alexh95/3d-models/u3421we-riser/docs/concepts-exploded.png

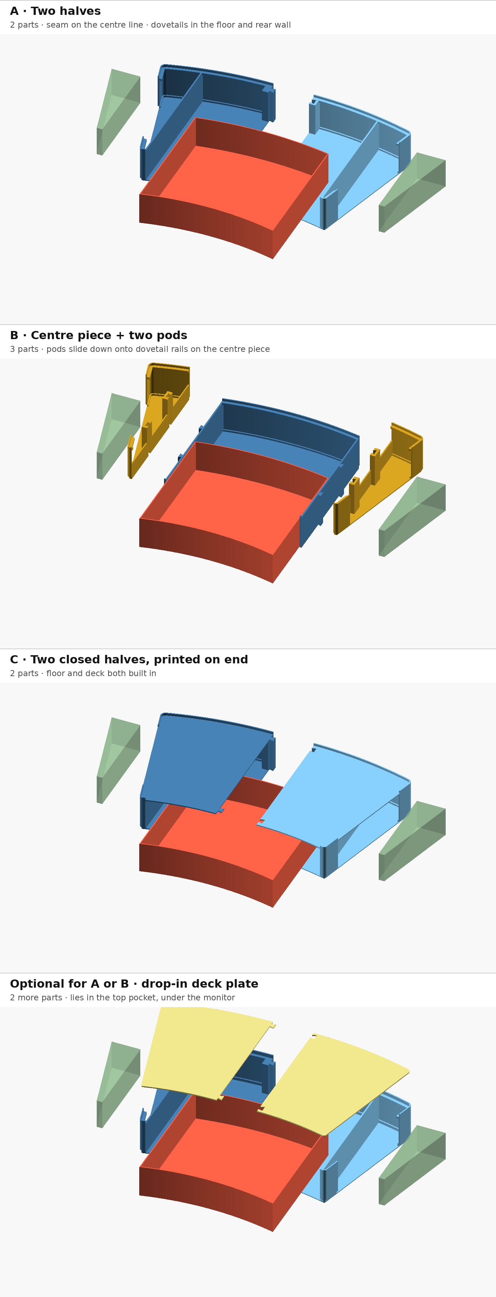
u3421we-riser/docs/concepts-exploded.png
