alexh95/3d-models/u3421we-riser/docs/interface-exploded.png

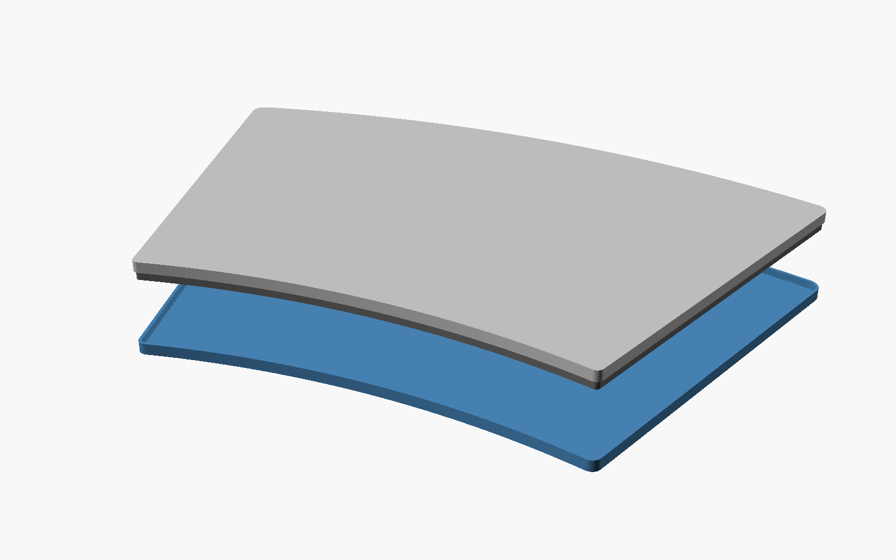
u3421we-riser/docs/interface-exploded.png
