alexh95/3d-models/u3421we-riser/docs/joint-concepts.png

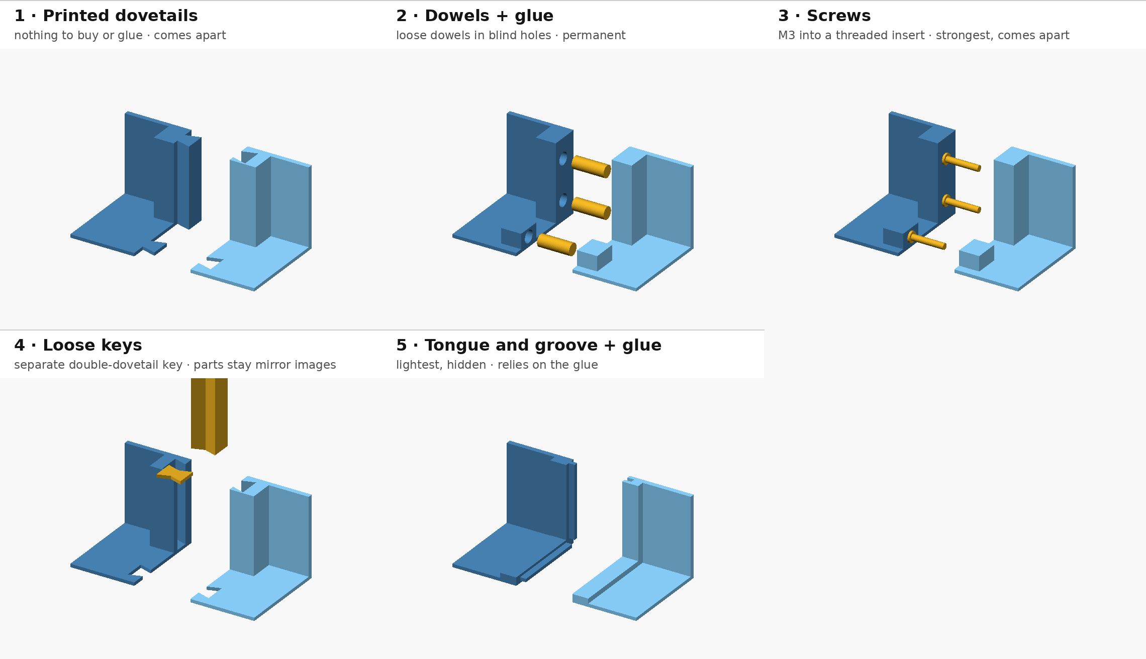
u3421we-riser/docs/joint-concepts.png
