alexh95/3d-models/u3421we-riser/docs/outline-u3421we.png

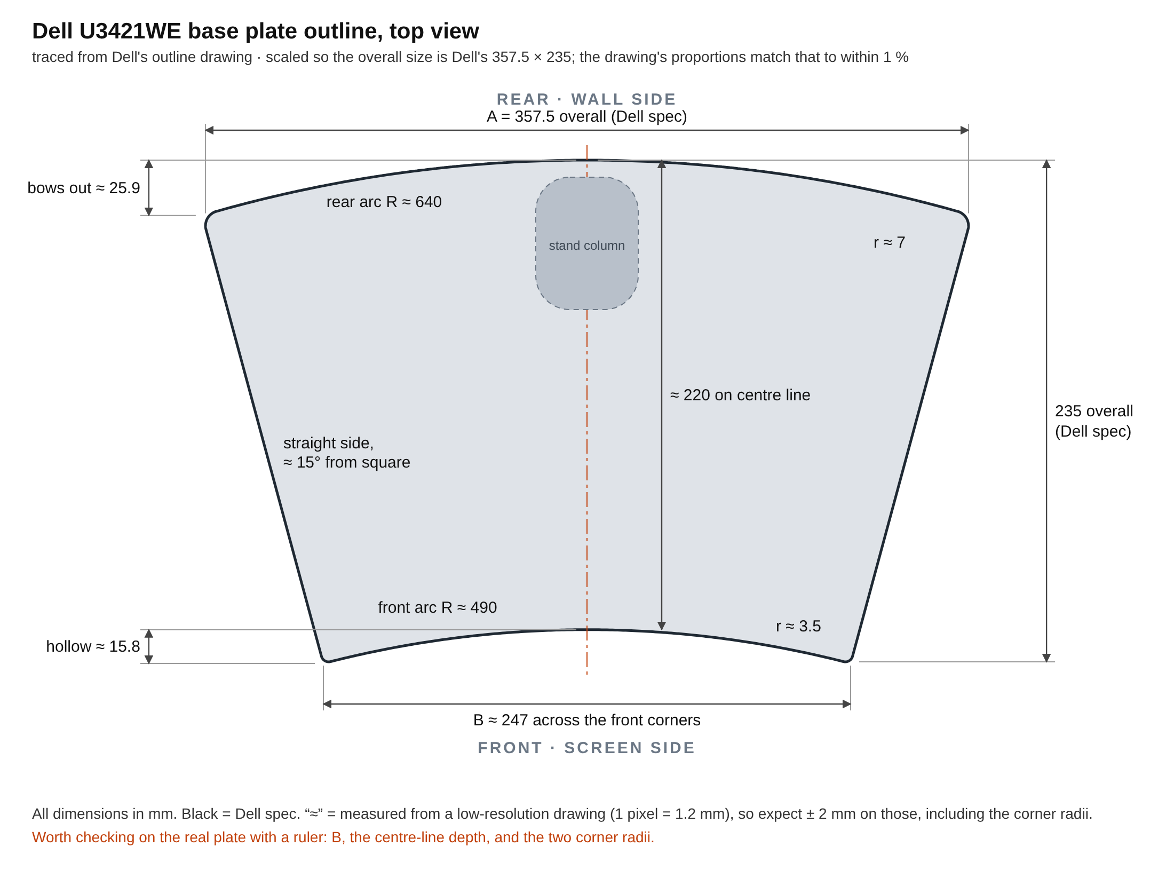
u3421we-riser/docs/outline-u3421we.png
