alexh95/3d-models/u3421we-riser/docs/riser-hub.png

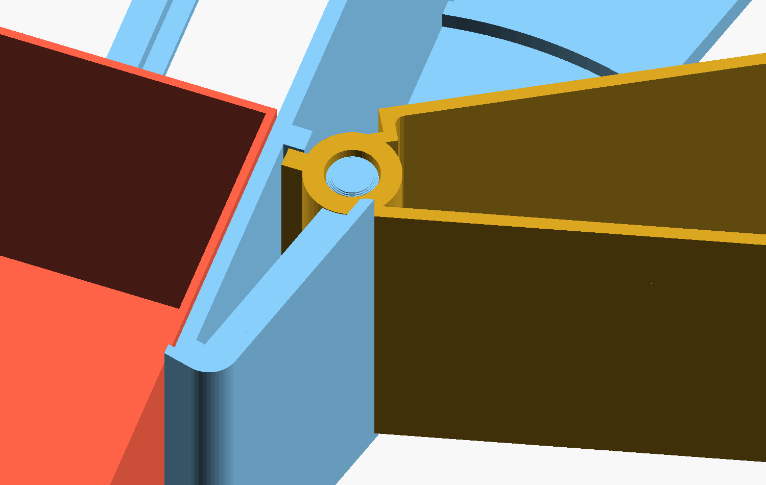
u3421we-riser/docs/riser-hub.png
