alexh95/3d-models/u3421we-riser/docs/seat-section.png

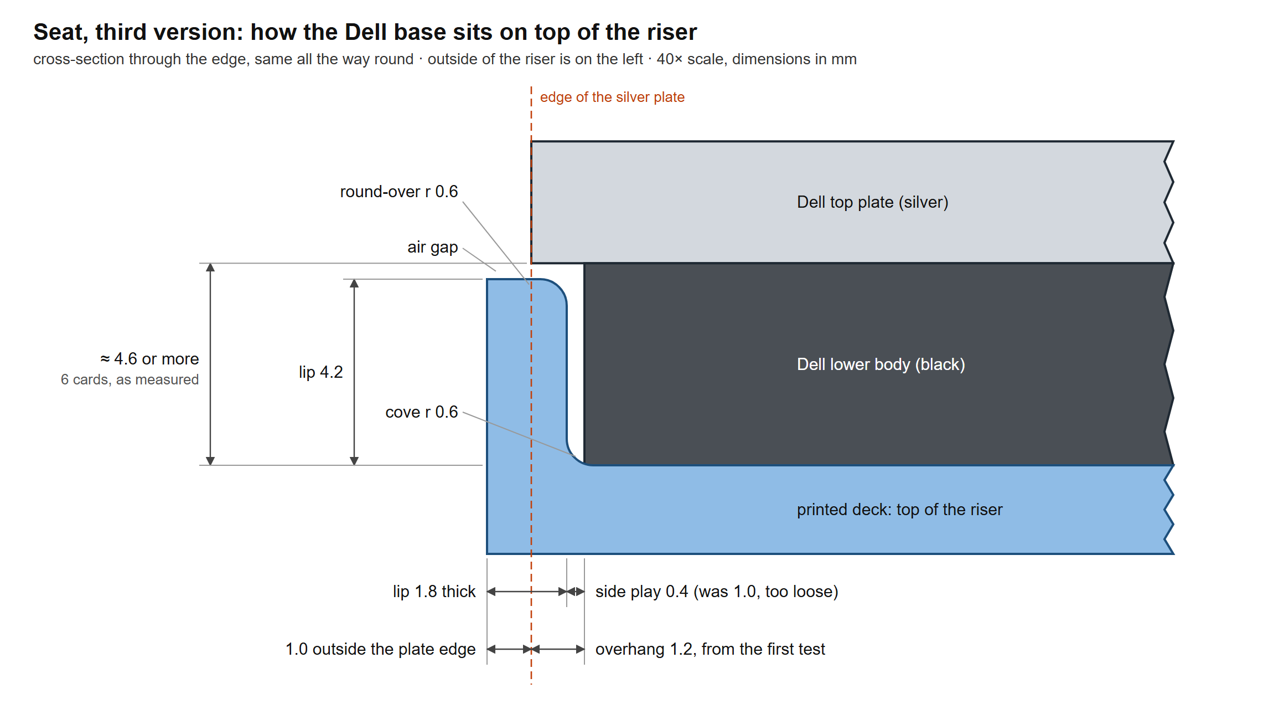
u3421we-riser/docs/seat-section.png
