alexh95/3d-models/u3421we-riser/stl/module_60mm/drawer_plain.stl

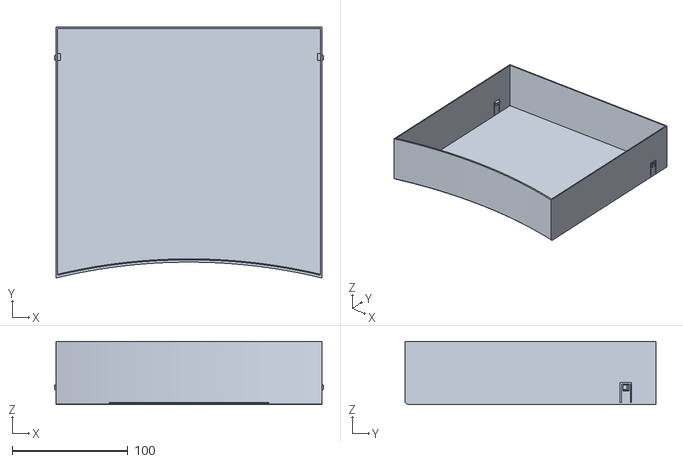
[picture p11: CAD file, 2026-11-13]
u3421we-riser/stl/module_60mm/drawer_plain.stl
232.8 x 217.2 x 54.8
