alexh95/3d-models/u3421we-riser/stl/plate_8mm/plate_left.stl

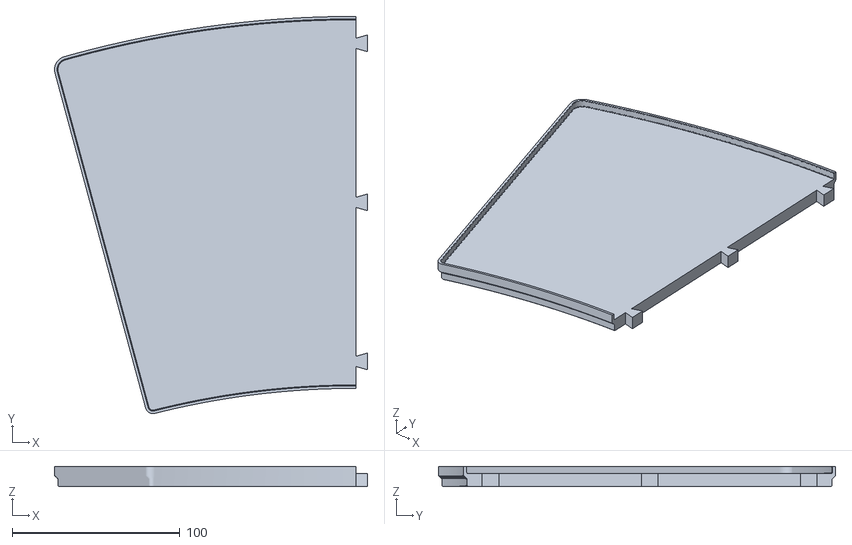
[picture p12: CAD file, 2026-11-13]
u3421we-riser/stl/plate_8mm/plate_left.stl
186.7 x 237.0 x 12.2
