alexh95/3d-models/u3421we-riser/stl/fit_test_right.stl

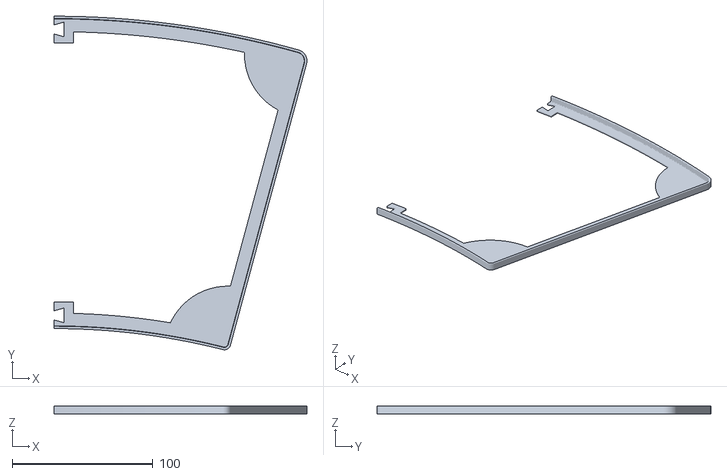
[picture p14: CAD file, 2026-11-13]
u3421we-riser/stl/fit_test_right.stl
179.7 x 237.0 x 5.40
