alexh95/3d-models/u3421we-riser/stl/module_60mm/wedge_swivel_r.stl

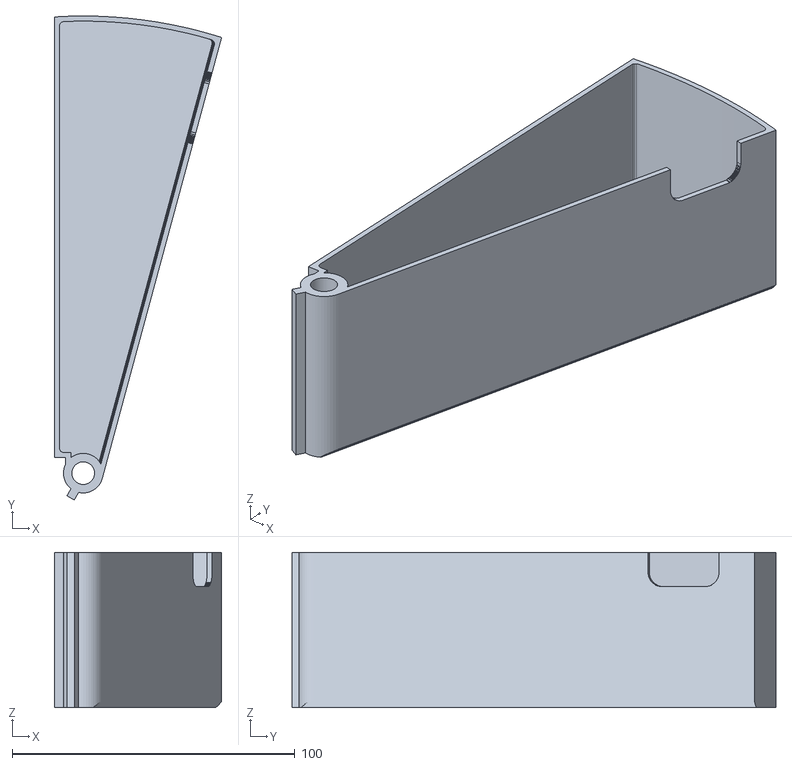
[picture p15: CAD file, 2026-11-13]
u3421we-riser/stl/module_60mm/wedge_swivel_r.stl
59.1 x 171.1 x 54.8
