alexh95/3d-models/u3421we-riser/stl/plate_8mm/plate_right.stl

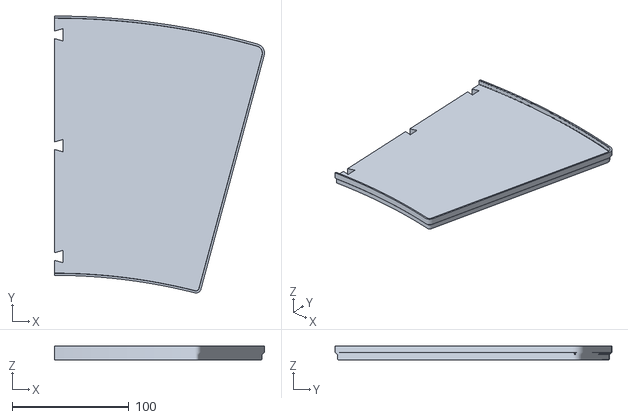
[picture p16: CAD file, 2026-11-13]
u3421we-riser/stl/plate_8mm/plate_right.stl
179.7 x 237.0 x 12.2
