alexh95/3d-models/u3421we-riser/stl/tests/test_front_drawer.stl

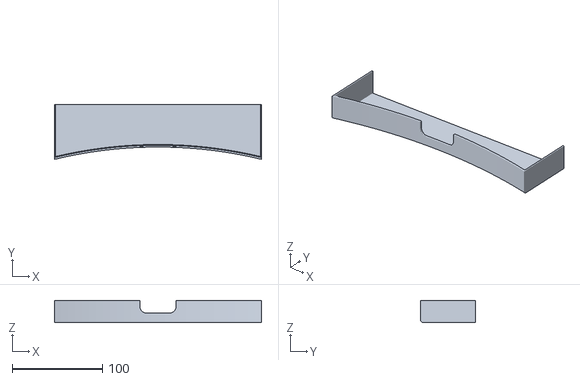
[picture p17: CAD file, 2026-11-13]
u3421we-riser/stl/tests/test_front_drawer.stl
230.0 x 60.9 x 24.8
