alexh95/3d-models/u3421we-riser/stl/module_60mm/body_left.stl

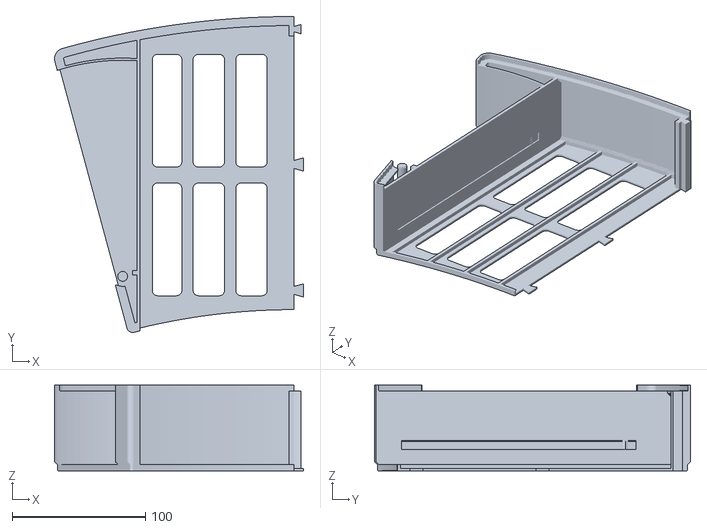
[picture p18: CAD file, 2026-11-13]
u3421we-riser/stl/module_60mm/body_left.stl
186.7 x 237.0 x 64.2
