alexh95/3d-models/u3421we-riser/stl/tests/test_seam_right.stl

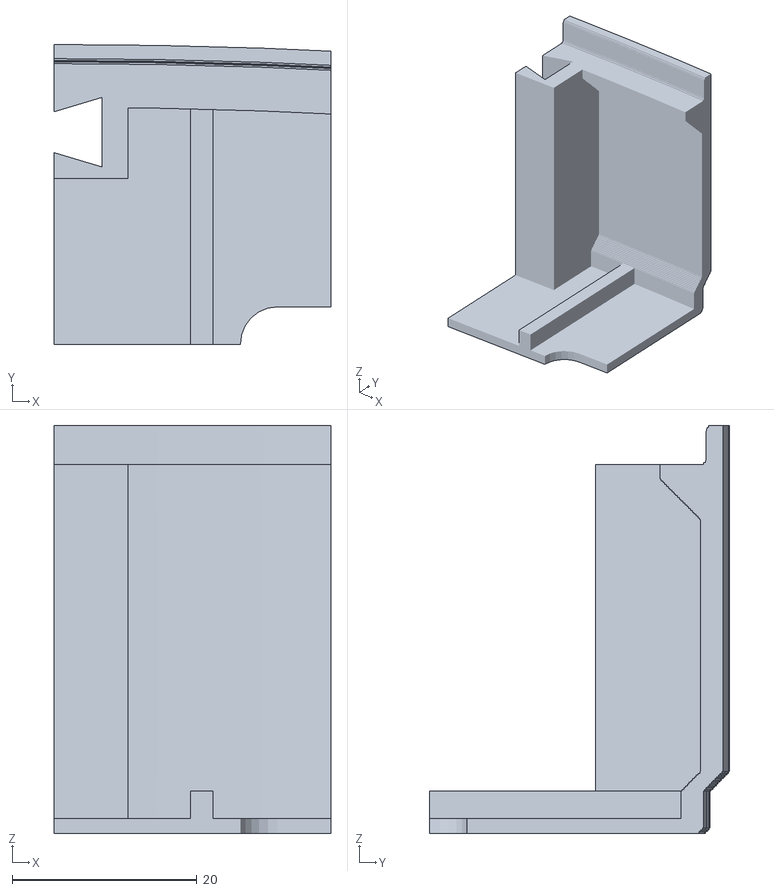
[picture p19: CAD file, 2026-11-13]
u3421we-riser/stl/tests/test_seam_right.stl
30.0 x 32.5 x 44.2
