alexh95/3d-models/u3421we-riser/stl/tests/test_stop_drawer.stl

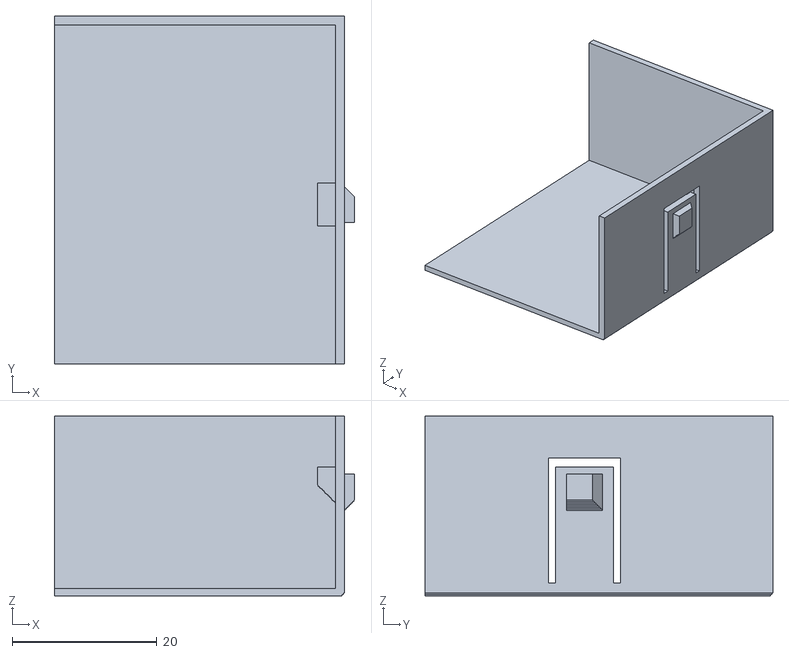
[picture p20: CAD file, 2026-11-13]
u3421we-riser/stl/tests/test_stop_drawer.stl
41.4 x 48.0 x 24.8
