alexh95/3d-models/u3421we-riser/web/meshes/body_right.stl

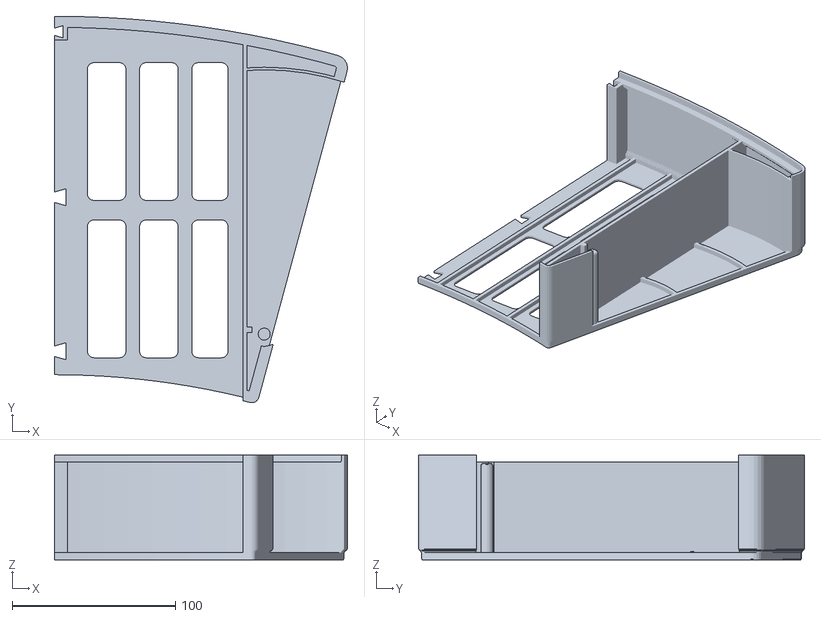
[picture p21: CAD file, 2026-11-13]
u3421we-riser/web/meshes/body_right.stl
179.7 x 237.0 x 64.2
