alexh95/3d-models/u3421we-riser/stl/tests/test_hub_body.stl

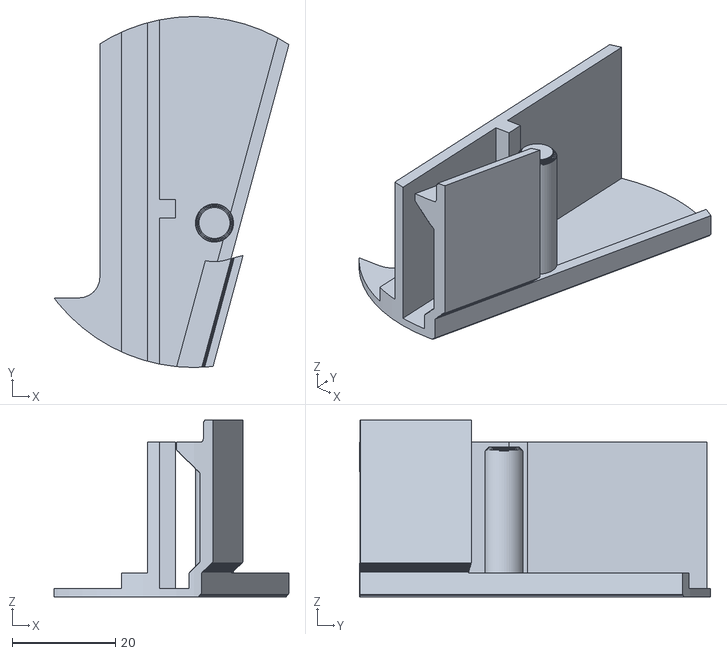
[picture p22: CAD file, 2026-11-13]
u3421we-riser/stl/tests/test_hub_body.stl
45.5 x 68.0 x 34.2
