alexh95/3d-models/u3421we-riser/stl/tests/test_hub_drawer.stl

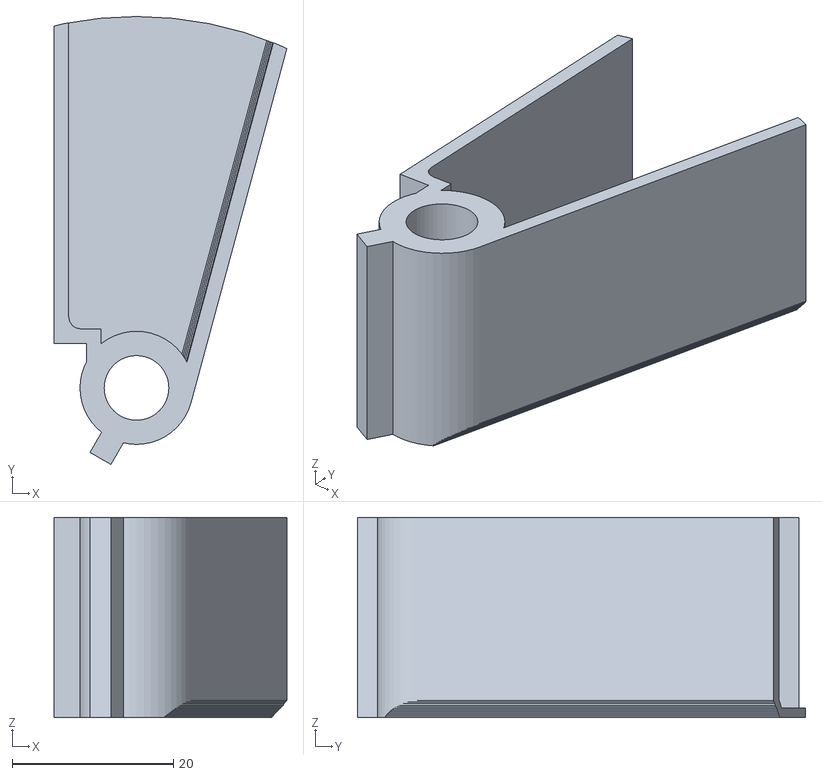
[picture p23: CAD file, 2026-11-13]
u3421we-riser/stl/tests/test_hub_drawer.stl
28.8 x 55.5 x 24.8
