alexh95/3d-models/u3421we-riser/stl/tests/test_stop_body.stl

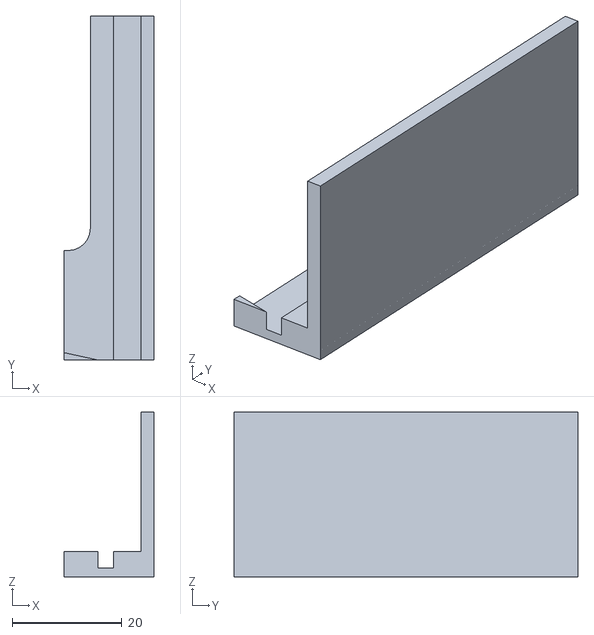
[picture p25: CAD file, 2026-11-13]
u3421we-riser/stl/tests/test_stop_body.stl
16.4 x 62.6 x 30.0
