alexh95/3d-models/u3421we-riser/stl/tests/test_step_right.stl

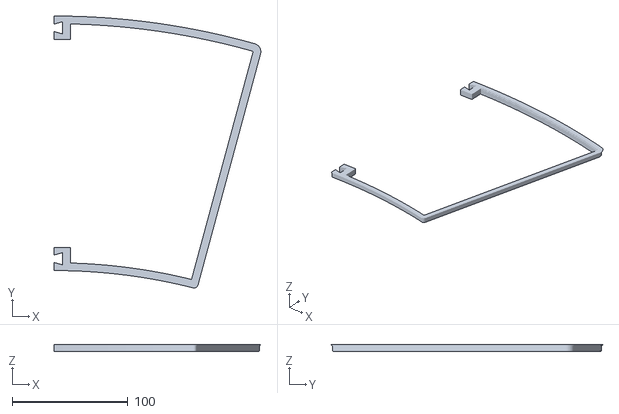
[picture p26: CAD file, 2026-11-13]
u3421we-riser/stl/tests/test_step_right.stl
178.9 x 235.3 x 5.80
