alexh95/3d-models/u3421we-riser/web/meshes/dell_black.stl

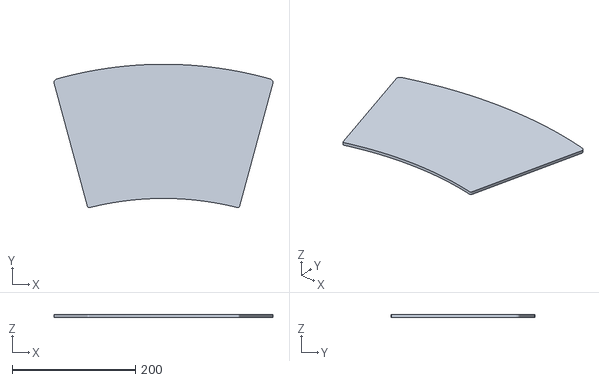
[picture p27: CAD file, 2026-11-12]
u3421we-riser/web/meshes/dell_black.stl
355.0 x 232.6 x 4.56
