alexh95/3d-models/u3421we-riser/stl/tests/test_front_right.stl

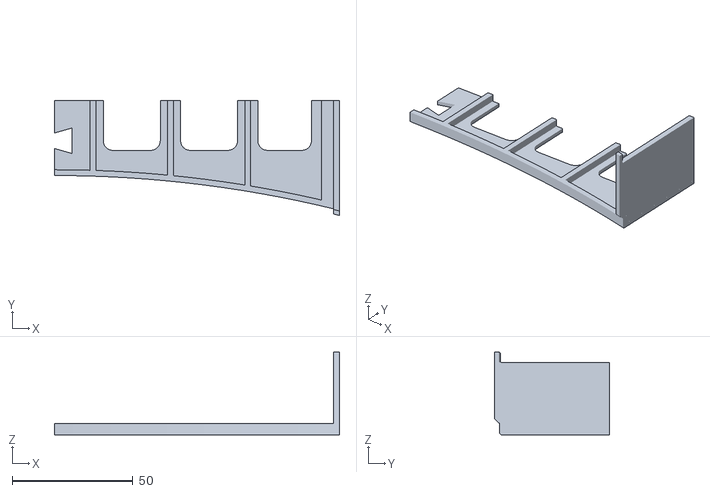
[picture p28: CAD file, 2026-11-13]
u3421we-riser/stl/tests/test_front_right.stl
118.0 x 47.6 x 34.2
