alexh95/3d-models/u3421we-riser/web/meshes/dell_plate.stl

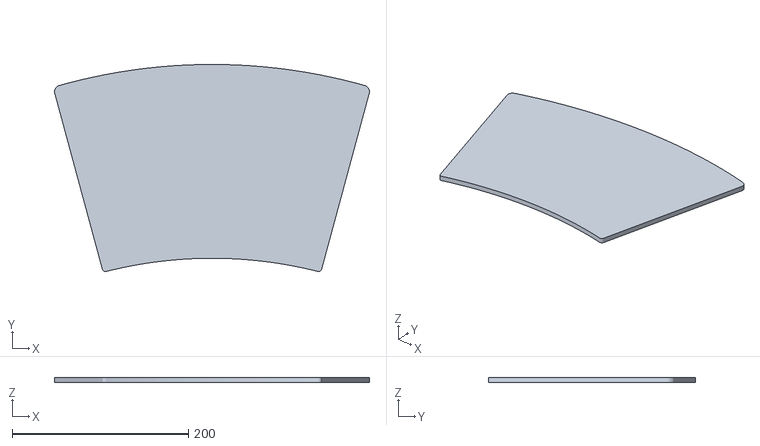
[picture p29: CAD file, 2026-11-12]
u3421we-riser/web/meshes/dell_plate.stl
357.4 x 235.0 x 6.00
