alexh95/3d-models/u3421we-riser/stl/tests/test_seam_left.stl

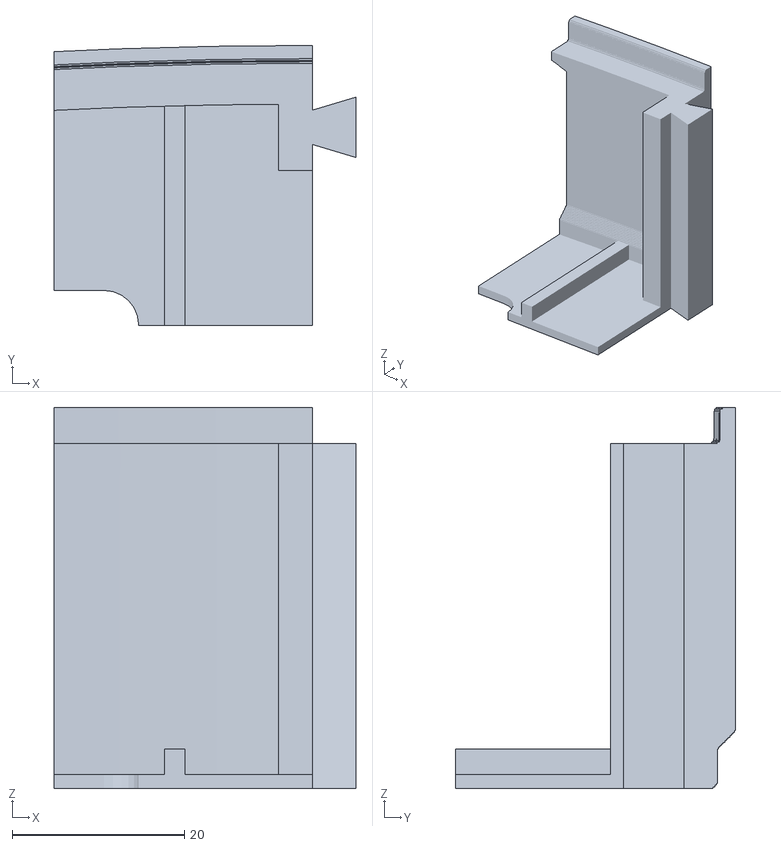
[picture p30: CAD file, 2026-11-13]
u3421we-riser/stl/tests/test_seam_left.stl
35.0 x 32.5 x 44.2
