alexh95/3d-models/(list of files, cad)

Other CAD files:
u3421we-riser/web/meshes/drawer_scoop.stl
u3421we-riser/web/meshes/plate_left.stl
u3421we-riser/web/meshes/wedge_swivel_l.stl
u3421we-riser/stl/module_60mm/drawer_scoop.stl
u3421we-riser/stl/module_60mm/wedge_swivel_l.stl
u3421we-riser/web/meshes/plate_right.stl
u3421we-riser/stl/module_60mm/body_right.stl
u3421we-riser/web/meshes/body_left.stl
u3421we-riser/web/meshes/wedge_swivel_r.stl
u3421we-riser/web/meshes/drawer_plain.stl
