alexh95/3d-models/u3421we-riser/docs/concepts-print-plates.png

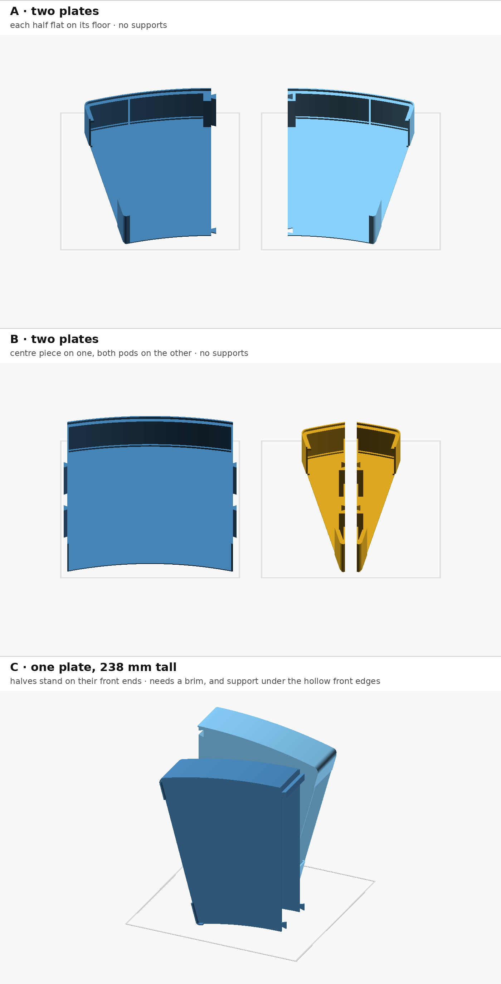
u3421we-riser/docs/concepts-print-plates.png
