alexh95/3d-models/u3421we-riser/docs/riser-print-plates.png

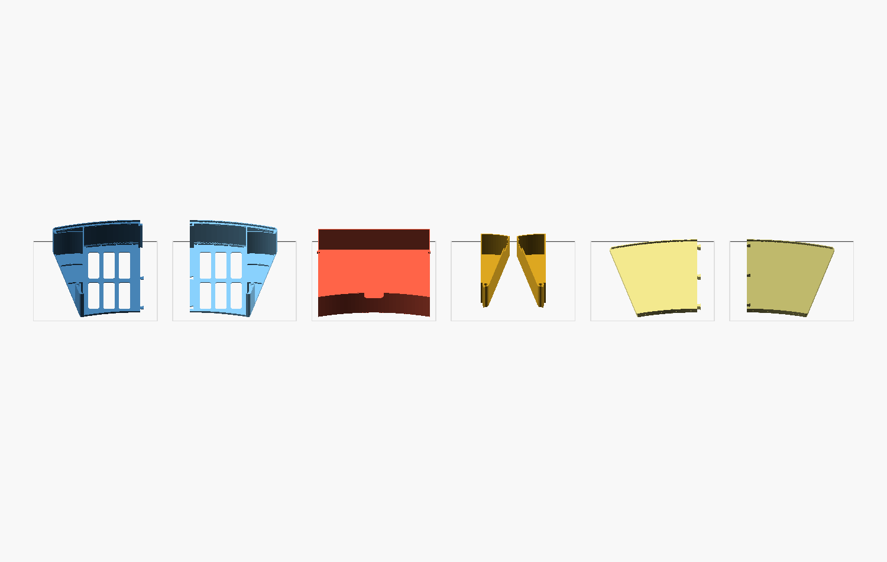
u3421we-riser/docs/riser-print-plates.png
