alexh95/3d-models/u3421we-riser/docs/fit-test-ring.png

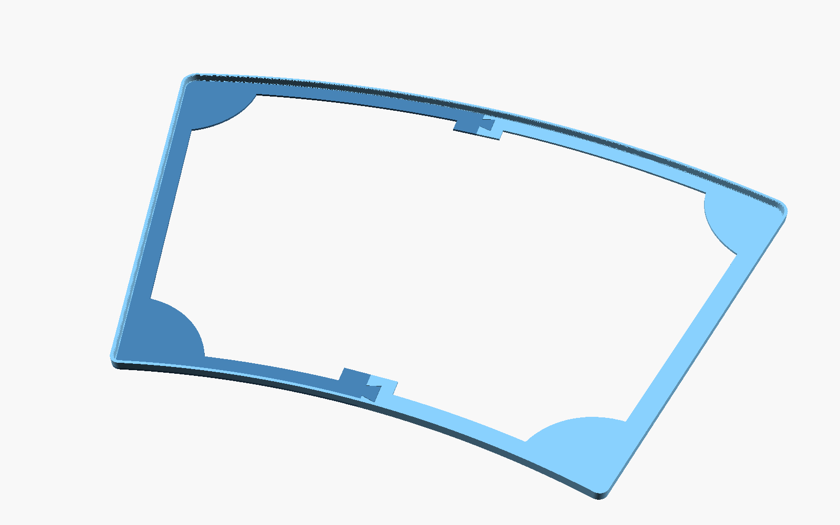
u3421we-riser/docs/fit-test-ring.png
