alexh95/3d-models/u3421we-riser/docs/outline-u3421we-1to1-A4.pdf

## U3421WE base plate, 1:1, LEFT half (top view)

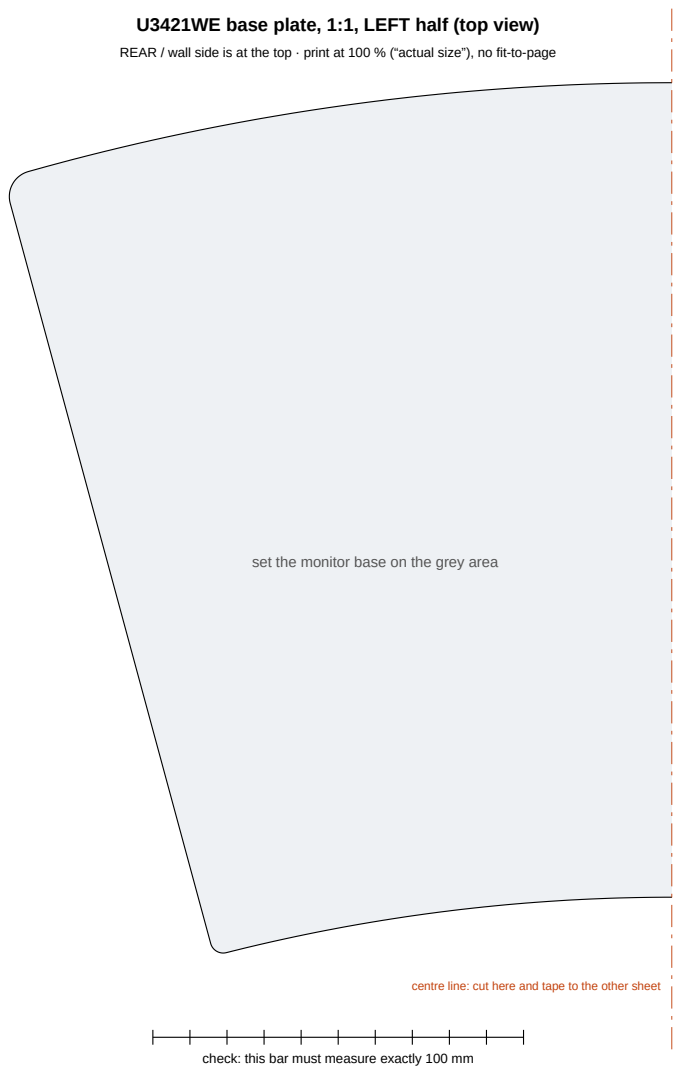
[picture p34: page 1]

REAR / wall side is at the top · print at 100 % (“actual size”), no fit-to-page

set the monitor base on the grey area

centre line: cut here and tape to the other sheet

check: this bar must measure exactly 100 mm

## U3421WE base plate, 1:1, RIGHT half (top view)

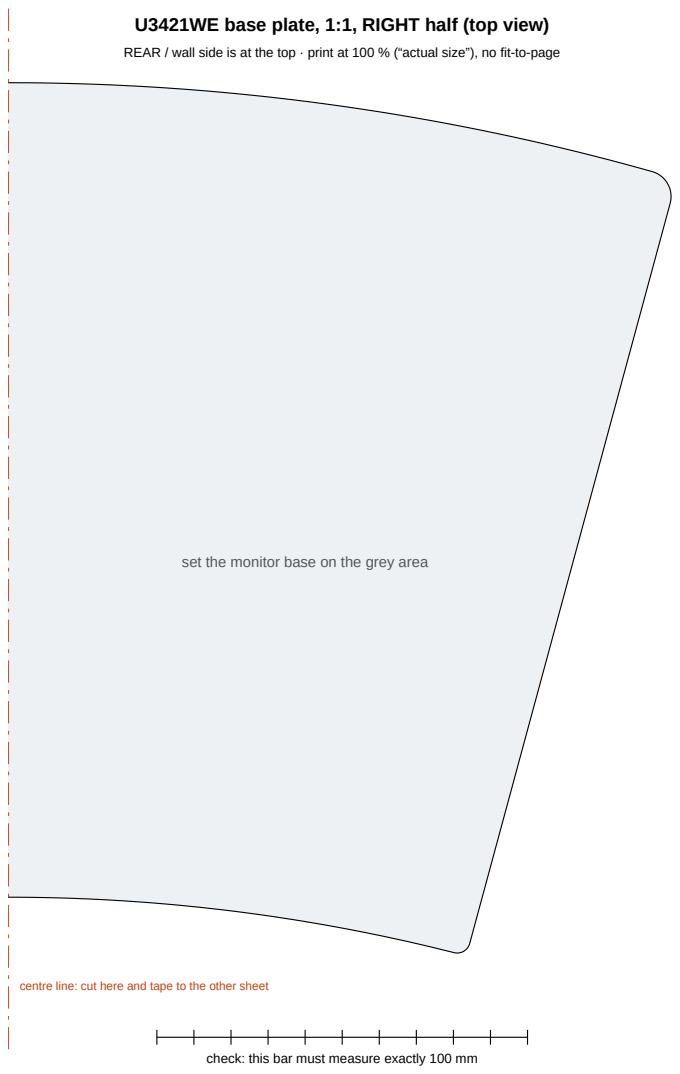
[picture p35: page 2]

REAR / wall side is at the top · print at 100 % (“actual size”), no fit-to-page

set the monitor base on the grey area

centre line: cut here and tape to the other sheet

check: this bar must measure exactly 100 mm
