alexh95/3d-models/(commit log)

2026-11-12 Add candidate footprint sketches for Dell U3421WE base plate
    Top-view drawings of three possible base plate outlines, used to confirm
    the real shape before modelling the monitor riser.
    Claude-Session: https://claude.ai/code/session_014zX93QQ3wWANBvZkGMxWMs
2026-11-12 Add arc-edge footprint variants for the base plate
    The plate is a trapezoid wider at the back whose front and rear edges are
    arcs. Sketch the four possible bow directions and list the measurements
    needed to model the outline.
    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
2026-11-12 Add plate-to-riser interface sketch
    Cross-sections of two ways the monitor base plate can register on the top
    module (perimeter lip vs. foot pockets) and the plate edge profiles to
    choose from, for confirmation before modelling.
    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
2026-11-12 Add traced U3421WE base plate outline and 1:1 paper template
    Outline traced from Dell's outline drawing: straight sides converging
    toward the front, convex rear arc, concave front arc, overall 357.5 x 235.
    Includes a dimensioned drawing and a two-page A4 template for checking the
    outline against the real plate. Replaces the earlier guess sketches.
    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
2026-11-12 Model the U3421WE base outline and its seat in OpenSCAD
    outline.scad holds the confirmed base plate outline as a reusable 2D
    module. interface_check.scad models the Dell base as measured (top plate
    overhanging a black lower body) together with the seat it drops into: a
    low lip that tucks under the overhang, flush with the plate outline.
    Moves the drawings under u3421we-riser/ and replaces the interface options
    sketch with a dimensioned section of the chosen seat.
    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
    [interface_check.scad, outline.scad]
2026-11-12 Make interface_check.scad self-contained
    The file pulled the plate outline from outline.scad, so downloading it on
    its own gave an empty preview. Fold the outline into the file and add an
    "outline only" view in its place.
    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
    [interface_check.scad, outline.scad]
2026-11-12 Add a printable fit-test ring for the seat
    A thin two-part ring carrying the same lip the riser will have, so the
    outline, overhang and lip height can be checked against the real monitor
    base. Split on the centre line to fit a 256 mm bed, joined by dovetails,
    with wider patches at the corners for the rubber feet to land on. The lip
    gains a small lead-in bevel on its inside top edge.
    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
    [fit_test_left.stl, fit_test_right.stl, interface_check.scad]
2026-11-12 Revise the seat after the first fit test
    The first ring fitted with no side play and a larger air gap than wanted.
    Move the lip's inside face out by 1 mm and its outside face out by 1.6 mm
    (lip now 1.8 thick, standing 1.6 outside the plate edge), raise it from
    3.8 to 4.2, and replace the top bevel with 0.6 fillets on the inside top
    edge and at the foot of the lip. Record the overhang the test implied
    (1.2) and regenerate the test ring, drawing and previews.
    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
    [fit_test_left.stl, fit_test_right.stl, interface_check.scad]
2026-11-12 Add rough concept models for splitting and joining a module
    split_concepts.scad compares three ways to break one riser module into
    parts that fit a 256 mm bed: two halves, a centre piece with two wedge
    pods, and two closed halves printed on end, with an optional drop-in deck
    plate. joint_concepts.scad shows five seam joints on a small sample:
    printed dovetails, dowels and glue, screws, loose keys, and tongue and
    groove. Both are block models for comparison, not the final design.
    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
    [joint_concepts.scad, split_concepts.scad]
2026-11-12 Record the option A decision and add design notes for handoff
    DESIGN.md collects everything needed to continue the riser from the
    repository alone: requirements, the confirmed outline and how it was
    traced, the underside measurements, the seat and its fit-test history,
    the decision to split modules into two halves, the options not chosen,
    ideas not yet designed, open questions and the planned next steps.
    Adds the scripts used to trace the outline, draw the diagrams and measure
    parts under tools/, and a short CLAUDE.md with the repository conventions.
    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
2026-11-12 Add the phase plan and the filament data
    PLAN.md lays out the next phases: the riser model and its top plate, the
    designer website, and the links to cydonia, with the owner's decisions of
    2026-11-13. docs/filaments-2026-11-12.md is the colour and price data set
    for the website's filament catalogue.
2026-11-12 Add the riser model: module, drawers, top plate and test pieces
    riser.scad holds the two body halves, the main drawer, the swivelling
    wedge drawers, the stackable top plate and five test pieces, with the
    module's height as a parameter. Every drawer rides above the stepped-in
    zone, so it opens over any lip underneath.
    tools/riser_build.py checks the model (bed fit, overlaps, overhangs, and
    that another height is the same mesh with a longer straight section),
    exports the STLs, slices them with Bambu Studio and writes the bundle
    for the designer website. DESIGN.md section 12 is the record.
    [riser.scad]
2026-11-12 Add the ready-made STL set, the test pieces and the website bundle
    A 60 mm module and an 8 mm top plate ready to slice, the test pieces
    that check each new fit, and web/ with one mesh per part plus sliced
    weights and print times for the designer website.
    [body_left.stl, body_right.stl, dell_black.stl, dell_plate.stl, drawer_plain.stl, drawer_scoop.stl, plate_left.stl, plate_right.stl]
2026-11-13 Shrink the seat by 0.6 mm each side (third version)
    Fit-test ring 2 was a bit too loose. The inside face of the lip moves
    from 0.2 to 0.8 inside the plate edge, which leaves 0.4 mm of play each
    side. The lip keeps its thickness, so the whole riser shrinks with it.
    Ring 3 confirmed the fit on 2026-11-13.
    Every model, the test pieces, the ready-made STL set, the slicer
    numbers, the website bundle and the pictures are rebuilt from it.
    riser_build.py stl now also writes the fit-test ring.
    [body_left.stl, body_right.stl, drawer_plain.stl, drawer_scoop.stl, fit_test_left.stl, fit_test_right.stl, interface_check.scad, plate_left.stl]
2026-11-13 Slice the top plate lighter: 10 percent infill, 4 top layers
    The plate is a solid slab, so the slicer decides most of its weight.
    With its own settings a pair of 8 mm halves is 200 g and 4 h 52, down
    from 239 g and 5 h 40. The walls stay at 3, and the modules keep their
    settings. DESIGN.md section 12 has the comparison.
    The website bundle carries the new estimates; its meshes are the same.
    The bundle's revision now covers the slicer's numbers as well as the
    model, so new estimates always give a new revision.
